happygithub1123/stm32-multimeter-replica/参考手册/器件手册索引.md

# 天空星数字万用表关键器件手册索引

整理日期：2026-09-18

筛选依据：当前项目的 `SCH_Schematic1_2_2026-09-17.pdf` 、`README.md` 和两套 STM32 固件。手册按“主控/显示、模拟测量链、量程切换、供电和输入保护”选取。

## 主控和显示

| 文件 | 对应器件 | 项目中的作用 | 来源 |
| --- | --- | --- | --- |
| [01_STM32F405-407_DS8626.pdf](01_STM32F405-407_DS8626.pdf) | STM32F407VET6 | 天空星主控 MCU，关键查阅 ADC、GPIO、SPI和电气参数 | [STMicroelectronics](https://www.st.com/resource/en/datasheet/stm32f407ig.pdf) |
| [02_STM32F4_RM0090_参考手册.pdf](02_STM32F4_RM0090_%E5%8F%82%E8%80%83%E6%89%8B%E5%86%8C.pdf) | STM32F407 外设 | 寄存器级参考手册，用于 ADC、DMA、SPI、定时器等调试 | [STMicroelectronics](https://www.st.com/resource/en/reference_manual/rm0090-stm32f4xx-reference-manual-stmicroelectronics.pdf) |
| [07_ST7735S_TFT控制器_数据手册.pdf](07_ST7735S_TFT%E6%8E%A7%E5%88%B6%E5%99%A8_%E6%95%B0%E6%8D%AE%E6%89%8B%E5%86%8C.pdf) | ST7735S | 1.8 英寸 128×160 TFT 模块控制器；固件初始化序列明确标注 ST7735S | [Sitronix 文档镜像](https://cdn.sparkfun.com/assets/9/0/2/5/8/ST7735S_v1.1.pdf) |

## 模拟测量链

| 文件 | 对应器件 | 项目中的作用 | 来源 |
| --- | --- | --- | --- |
| [03_TLV333-TLV2333-TLV4333_数据手册.pdf](03_TLV333-TLV2333-TLV4333_%E6%95%B0%E6%8D%AE%E6%89%8B%E5%86%8C.pdf) | TLV2333IDR、TLV333IDBVR | 电压差分放大、VREF 缓冲和电阻测量缓冲；同一份 TI 家族手册覆盖两种型号 | [Texas Instruments](https://www.ti.com/lit/ds/symlink/tlv333.pdf) |
| [04_TP181A1_电流检测放大器_数据手册.pdf](04_TP181A1_%E7%94%B5%E6%B5%81%E6%A3%80%E6%B5%8B%E6%94%BE%E5%A4%A7%E5%99%A8_%E6%95%B0%E6%8D%AE%E6%89%8B%E5%86%8C.pdf) | TP181A1-CR | 10 mΩ 分流器的双向电流检测，A1 型号固定增益 50 V/V | [3PEAK](https://static.3peak.com/res/doc/ds/Datasheet_TP181.pdf) |

## 量程切换和供电

| 文件 | 对应器件 | 项目中的作用 | 来源 |
| --- | --- | --- | --- |
| [05_GAQY211G2S_固态继电器_数据手册.pdf](05_GAQY211G2S_%E5%9B%BA%E6%80%81%E7%BB%A7%E7%94%B5%E5%99%A8_%E6%95%B0%E6%8D%AE%E6%89%8B%E5%86%8C.pdf) | GAQY211G2S | RES/VOL/CUR 通路选择，SOP-4 PhotoMOS 固态继电器 | [国晶微/SUPSiC（立创商城存档）](https://atta.szlcsc.com/upload/public/pdf/source/20251020/01ECD8E450E4AE083754AEA475BAC51E.pdf) |
| [08_AO3401_P沟道MOSFET_数据手册.pdf](08_AO3401_P%E6%B2%9F%E9%81%93MOSFET_%E6%95%B0%E6%8D%AE%E6%89%8B%E5%86%8C.pdf) | AO3401 | 100 Ω/1 kΩ/10 kΩ/100 kΩ 电阻量程切换 | [Alpha & Omega Semiconductor](https://www.aosmd.com/sites/default/files/res/datasheets/AO3401.pdf) |
| [06_LP5907_低噪声LDO_数据手册.pdf](06_LP5907_%E4%BD%8E%E5%99%AA%E5%A3%B0LDO_%E6%95%B0%E6%8D%AE%E6%89%8B%E5%86%8C.pdf) | LP5907MFX-3.3/NOPB | 5 V 转 3.3 V 模拟电源 | [Texas Instruments](https://www.ti.com/lit/ds/symlink/lp5907.pdf) |

## 输入保护和辅助开关

| 文件 | 对应器件 | 项目中的作用 | 来源 |
| --- | --- | --- | --- |
| [09_SJD12C40L01_TVS_数据手册.pdf](09_SJD12C40L01_TVS_%E6%95%B0%E6%8D%AE%E6%89%8B%E5%86%8C.pdf) | SJD12C40L01 | 40 V 双向 TVS，用于表笔/通路节点的瞬态保护 | [YAGEO](https://yageogroup.com/content/datasheet/asset/file/SJD12ACXXXL01_1) |
| [10_BSMD0603-010-36V_自恢复保险丝_数据手册.pdf](10_BSMD0603-010-36V_%E8%87%AA%E6%81%A2%E5%A4%8D%E4%BF%9D%E9%99%A9%E4%B8%9D_%E6%95%B0%E6%8D%AE%E6%89%8B%E5%86%8C.pdf) | BSMD0603-010-36V | 黑表笔负极控制支路的 36 V/0.1 A PPTC 自恢复保护 | [BHFUSE（立创商城存档）](https://atta.szlcsc.com/upload/public/pdf/source/20250403/B24B506D17FD49D2D6A20D6D815FE6C1.pdf) |
| [11_2N7002K_N沟道MOSFET_数据手册.pdf](11_2N7002K_N%E6%B2%9F%E9%81%93MOSFET_%E6%95%B0%E6%8D%AE%E6%89%8B%E5%86%8C.pdf) | 2N7002K | 黑表笔负极控制开关 | [Diodes Incorporated](https://www.diodes.com/datasheet/download/2N7002K.pdf) |

## 型号核对说明

- 原理图中是 **GAQY211G2S**，不是 Panasonic **AQY211G2S**。两者额定电流等参数不同，本目录保留的是 GAQY211G2S 精确型号手册。
- TLV2333IDR 和 TLV333IDBVR 属于 TLVx333 家族，TI 将两者放在同一份数据手册中。
- SJD12C40L01 使用 YAGEO `SJD12A(C)XXXL01` 系列手册，其精确型号列在 40 V 参数行。
- 2N7002K 是多厂商通用型号；原理图未标注厂商，此处收录 Diodes Incorporated 版本作为电气特性参考，采购时仍应按实际厂牌复核。

## 完整性检查

共 11 份 PDF。已检查 PDF 文件头、可解析页数，并核对手册中的关键型号。
