happygithub1123/stm32-multimeter-replica/说明文档.md

# 代码说明

- 简易万用表有两个版本，分别对应两个版本的代码；
- 两个版本代码有细微差异，不和互用；
