happygithub1123/stm32-multimeter-replica/原理图/SCH_Schematic1_2_2026-09-17.pdf

左边H1 | 右边H2

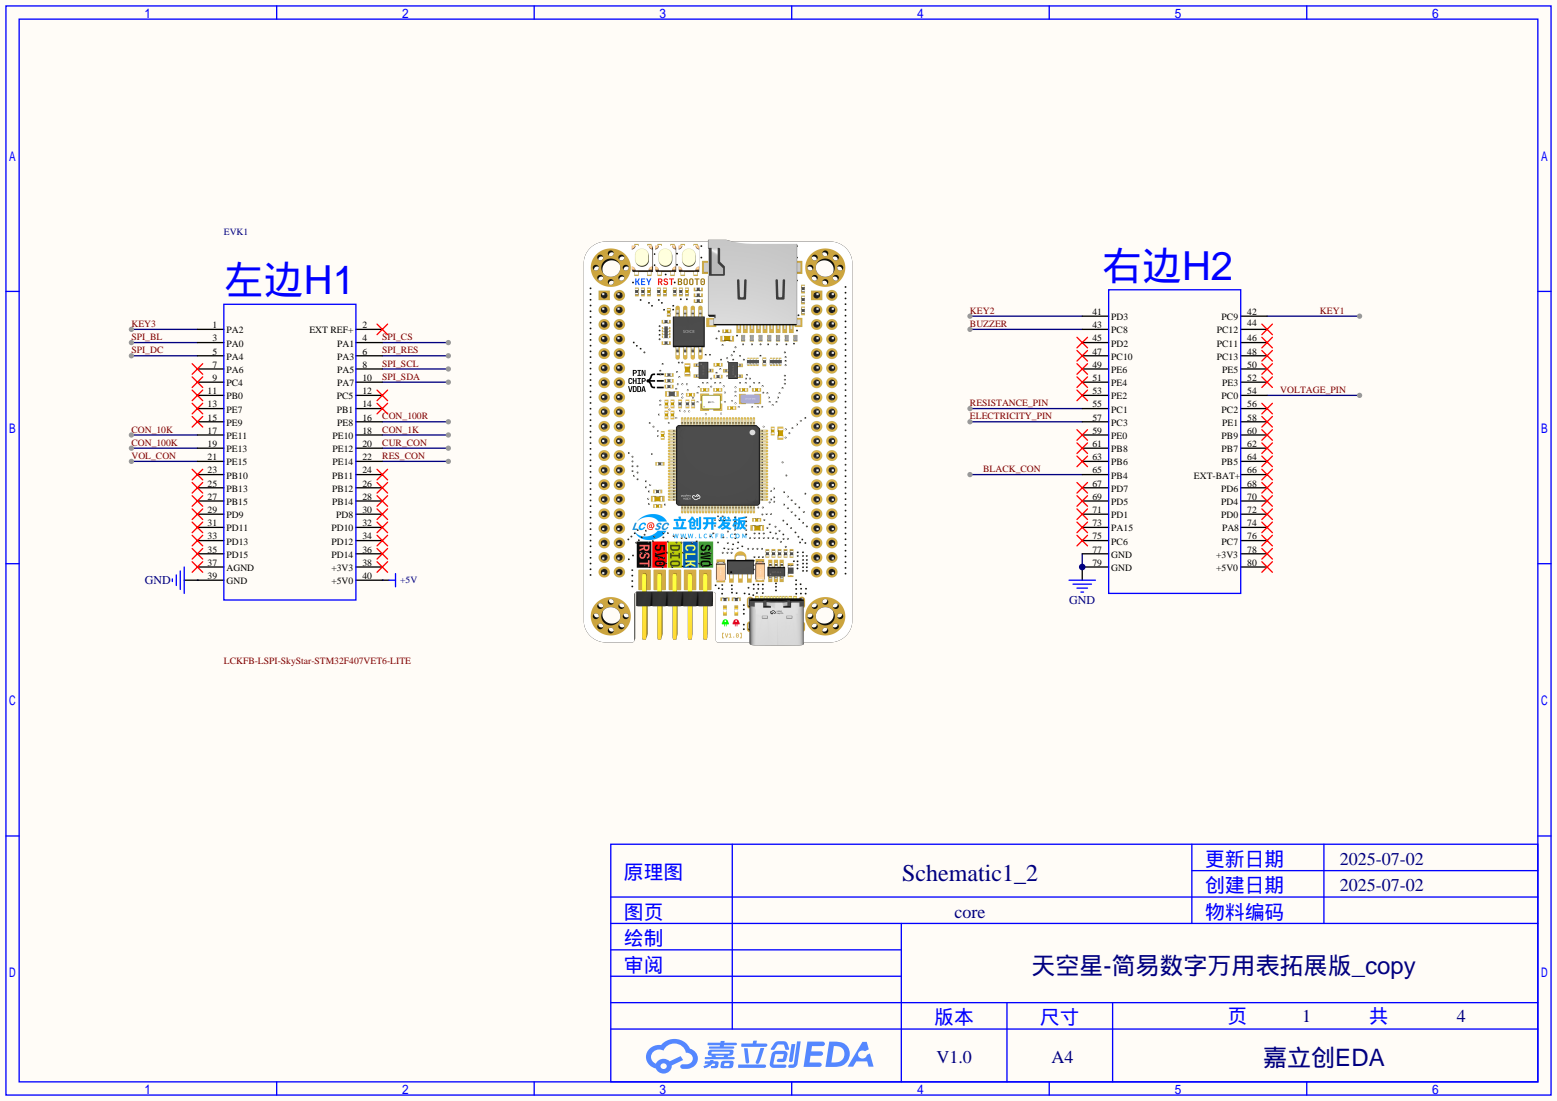
[picture p6: page 1]

LCKFB-LSPI-SkyStar-STM32F407VET6-LITE

U1

## 1.8寸TFT屏模块-8Pin

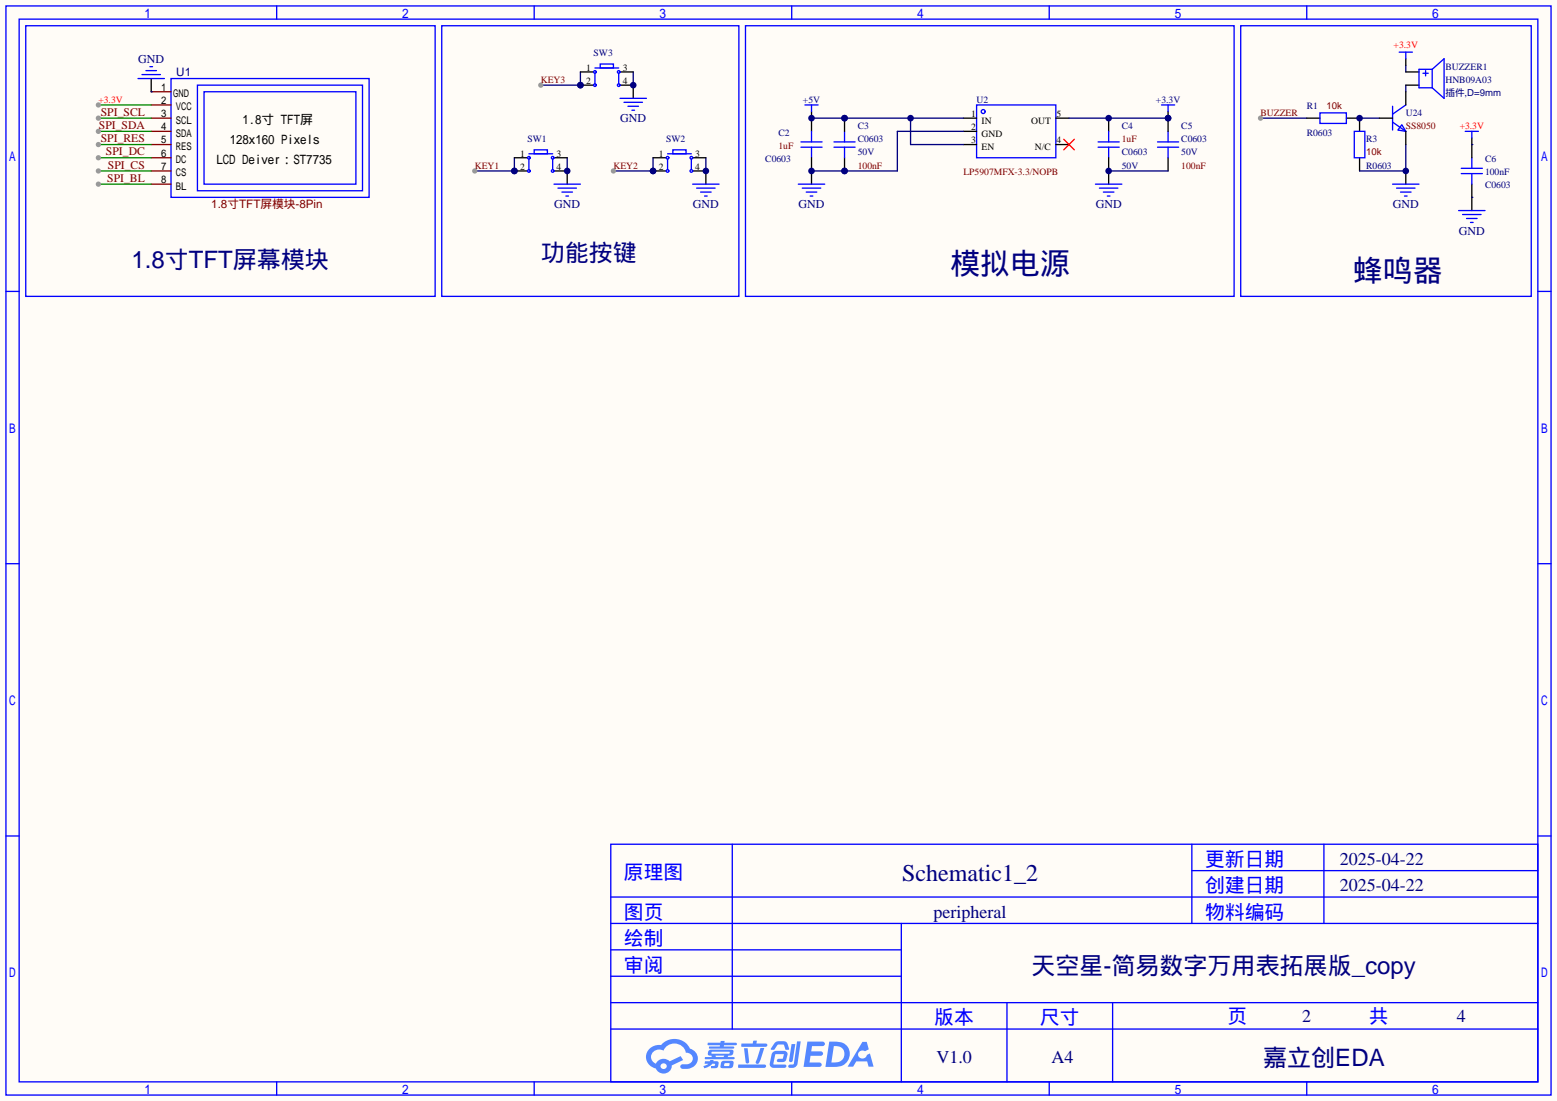
[picture p7: page 2]

### GND

### GND

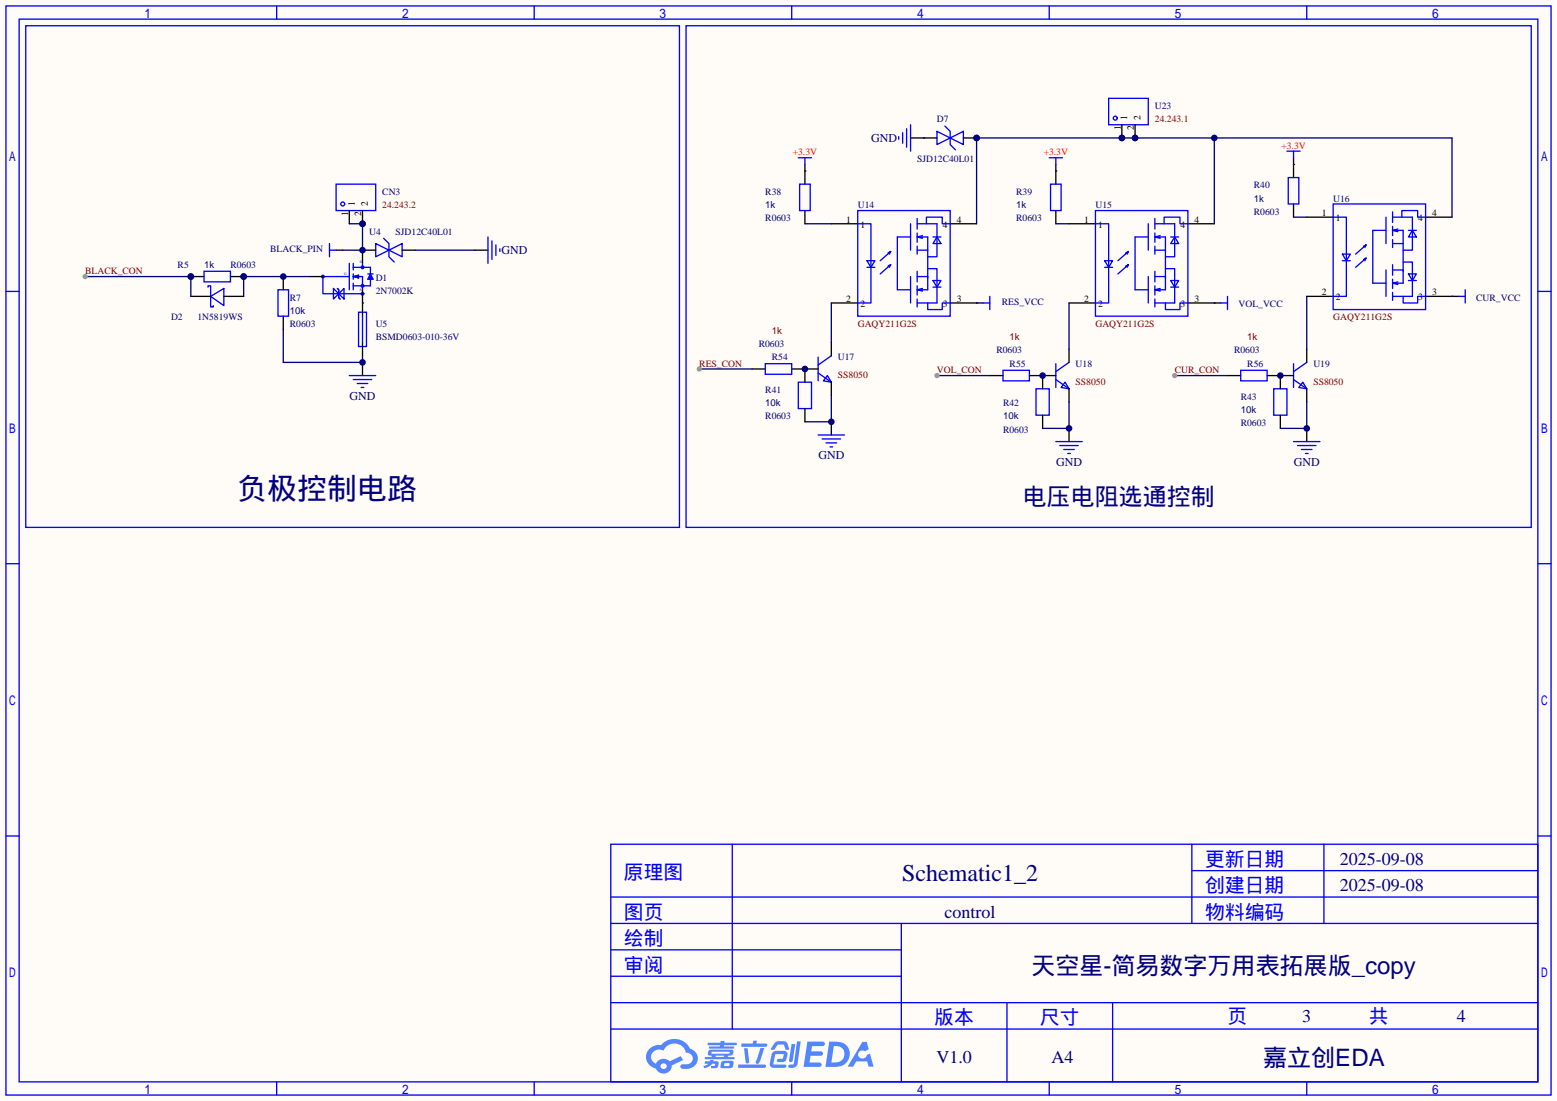
[picture p8: page 3]

### GND

### GND

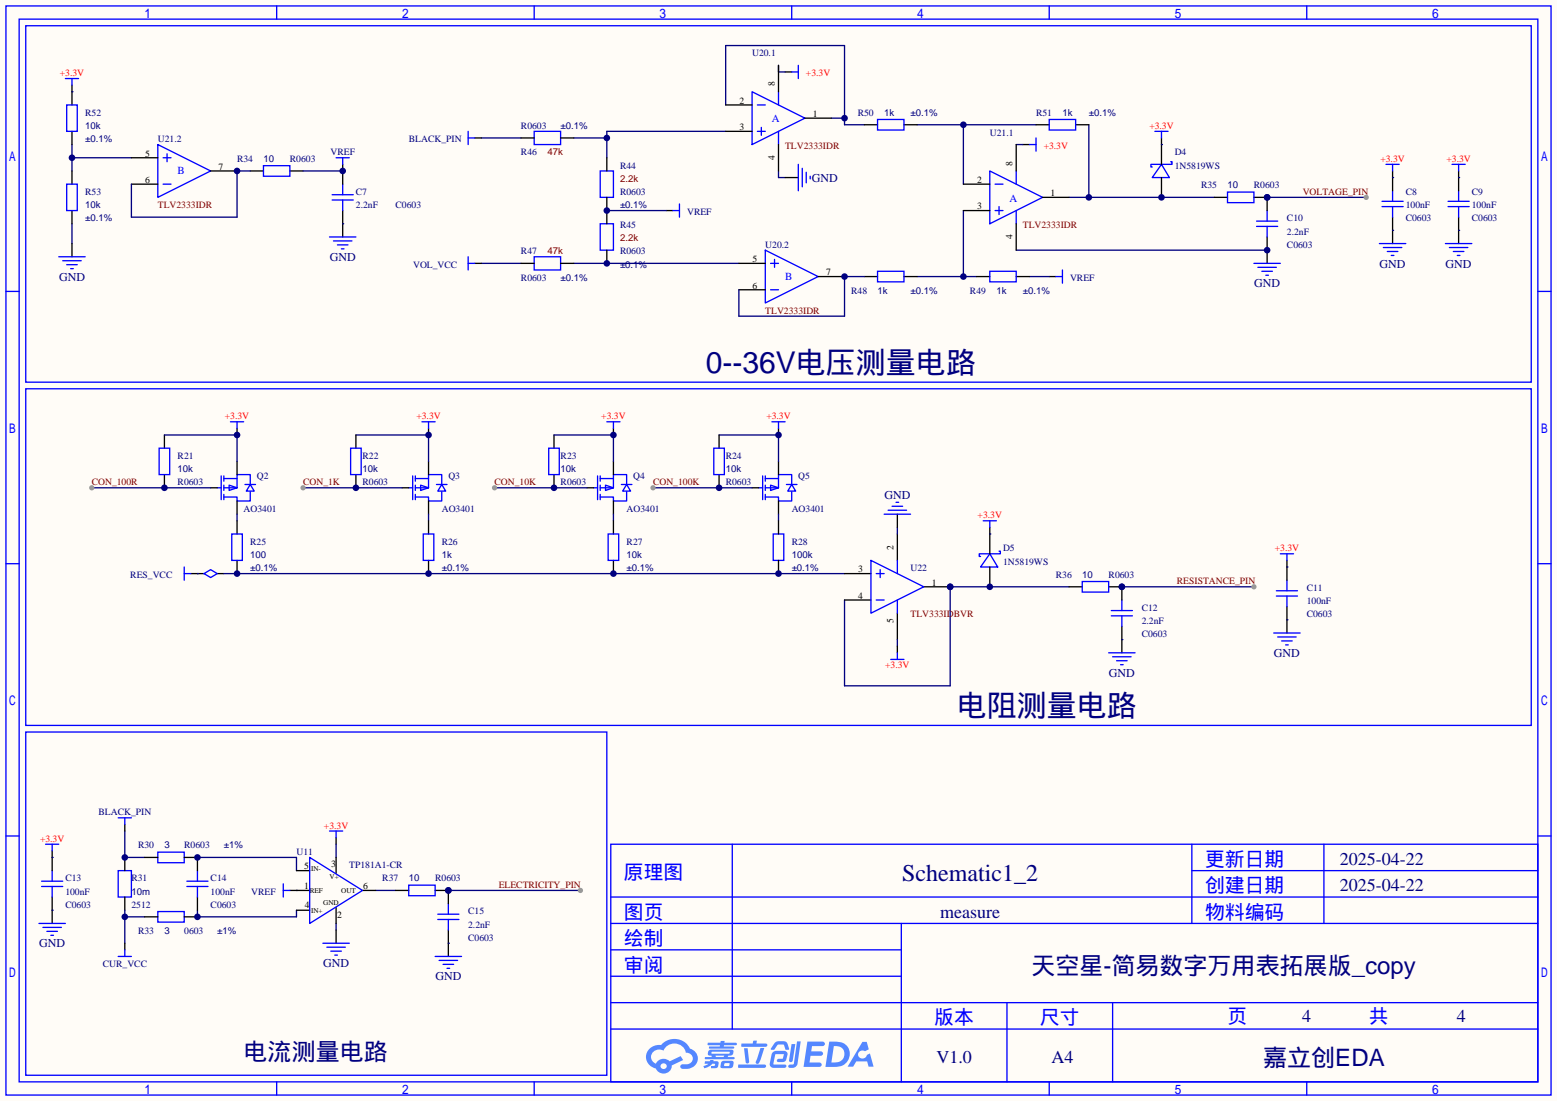
[picture p9: page 4]
