happygithub1123/stm32-multimeter-replica/stm32-multimeter-V2.0/Core/Src/main.c

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
/* Includes ------------------------------------------------------------------*/
#include "main.h"
#include "adc.h"
#include "iwdg.h"
#include "spi.h"
#include "tim.h"
#include "gpio.h"

/* USER CODE BEGIN Includes */
#include "bsp_key.h"
#include "bsp_tft.h"
#include "bsp_tftinit.h"
#include "bsp_timer.h"
#include "bsp_task.h"
/* USER CODE END Includes */


void SystemClock_Config(void);
/**
  * @brief  The application entry point.
  * @retval int
  */
int main(void)
{
  /* USER CODE BEGIN 1 */
	uint8_t keyValue = 0;							//获取按键值
	struct KeyInfo keyinfo = {0};			//按键切换信息
	
	keyinfo.mode = VOL_MODE;					//当前模式
	keyinfo.resistor_range = RES_0_100R;	//默认电阻分压
	keyinfo.ref_vol_value = 0;				//默认参考电压
  /* USER CODE END 1 */

  /* MCU Configuration--------------------------------------------------------*/

  /* Reset of all peripherals, Initializes the Flash interface and the Systick. */
  HAL_Init();

  /* Configure the system clock */
  SystemClock_Config();

  /* Initialize all configured peripherals */
  MX_GPIO_Init();
  MX_ADC1_Init();
  MX_SPI1_Init();
  MX_TIM3_Init();
  MX_IWDG_Init();
  /* USER CODE BEGIN 2 */
	//设置通道为内部参考电压
	Set_ADC_Channel(ADC_CHANNEL_VREFINT);
	keyinfo.ref_vol_value = Get_ADC_Average(200);	//获取200次平均值
	
	TFT_Init();											//初始化屏幕
	TFT_ShowStaticUI(keyinfo);			//显示静态UI
	HAL_TIM_Base_Start_IT(&htim3);	//消息定时器开始计时
	Mode_Switch(keyinfo.mode);			//模式切换所做操作
  /* USER CODE END 2 */

  /* Infinite loop */
  /* USER CODE BEGIN WHILE */
  while (1)
  {
    /* USER CODE END WHILE */

    /* USER CODE BEGIN 3 */
		if(wdgTimer >= 50)
		{
			HAL_IWDG_Refresh(&hiwdg);		//每隔50ms喂一次狗
			wdgTimer = 0;
		}
		if(keyTimer >= 10)						//每10ms进行按键扫描
		{	
			keyTimer = 0;
			keyValue = key_scanf();
			if(keyValue!=KEY_ERROR){
				key_handle(keyValue,&keyinfo);	//如果有按键按下则进行处理
			}	
			keyValue = KEY_ERROR;
		}
		if(keyinfo.mode == VOL_MODE)
		{
			//电压测量任务
			Voltage_Task(keyinfo.ref_vol_value);
		}
		else if(keyinfo.mode == RES_MODE)
		{
			//电阻测量任务
			Resistor_Task(&keyinfo,keyinfo.ref_vol_value);
		}
		else if(keyinfo.mode == CUR_MODE)
		{
			//电流测量任务
			Electricity_Task(keyinfo.ref_vol_value);
		}
		else if(keyinfo.mode == BUZ_MODE)
		{
			//通断测量任务
			Buzzing_Task(keyinfo.ref_vol_value);
		}
		else if(keyinfo.mode == DIODE_MODE)
		{
			//二极管测量任务
			Dio_Task(keyinfo.ref_vol_value);
		}
  }
  /* USER CODE END 3 */
}

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
