happygithub1123/stm32-multimeter-replica/stm32-multimeter-V2.0/Core/Inc/main.h

#define SPI_BL_Pin GPIO_PIN_0
#define SPI_BL_GPIO_Port GPIOA
#define SPI_CS_Pin GPIO_PIN_1
#define SPI_CS_GPIO_Port GPIOA
#define KEY3_Pin GPIO_PIN_2
#define KEY3_GPIO_Port GPIOA
#define SPI_RES_Pin GPIO_PIN_3
#define SPI_RES_GPIO_Port GPIOA
#define SPI_DC_Pin GPIO_PIN_4
#define SPI_DC_GPIO_Port GPIOA
#define CON_100R_Pin GPIO_PIN_8
#define CON_100R_GPIO_Port GPIOE
#define CON_1K_Pin GPIO_PIN_10
#define CON_1K_GPIO_Port GPIOE
#define CON_10K_Pin GPIO_PIN_11
#define CON_10K_GPIO_Port GPIOE
#define CUR_CON_Pin GPIO_PIN_12
#define CUR_CON_GPIO_Port GPIOE
#define CON_100K_Pin GPIO_PIN_13
#define CON_100K_GPIO_Port GPIOE
#define RES_CON_Pin GPIO_PIN_14
#define RES_CON_GPIO_Port GPIOE
#define VOL_CON_Pin GPIO_PIN_15
#define VOL_CON_GPIO_Port GPIOE
#define BUZZER_Pin GPIO_PIN_8
#define BUZZER_GPIO_Port GPIOC
#define KEY1_Pin GPIO_PIN_9
#define KEY1_GPIO_Port GPIOC
#define KEY2_Pin GPIO_PIN_3
#define KEY2_GPIO_Port GPIOD
#define BLACK_CON_Pin GPIO_PIN_4
#define BLACK_CON_GPIO_Port GPIOB
#define Res_Ohm			0x01
#define Res_KiloOhm	0x02
#define Res_TeraOhm	0x03
#define MAX_SAMPNUM 100	
