happygithub1123/stm32-multimeter-replica/stm32-multimeter-V2.0/BSP_Library/bsp_tftinit.c

#include "bsp_tftinit.h"
#include "spi.h"

/*
*   函数内容：TFT发送单个字节数据
*   函数参数：无
*   返回值：无
*/
void TFT_WR_DATA8(uint8_t data)
{
	LCD_CS_Clr();   //拉低片选信号
    
	HAL_SPI_Transmit(&hspi1,&data,1,HAL_MAX_DELAY);
    
	LCD_CS_Set();     //拉高片选信号
}

/*
*   函数内容：TFT发送2个字节数据
*   函数参数：无
*   返回值：无
*/
void TFT_WR_DATA(uint16_t data)
{
	uint8_t sendData[2] = {0};
	sendData[0] = (data>>8);
	sendData[1] = (data);
    
	LCD_CS_Clr();   //拉低片选信号
   
	HAL_SPI_Transmit(&hspi1,sendData,2,HAL_MAX_DELAY);     
    
	LCD_CS_Set();     //拉高片选信号
}

/*
*   函数内容：TFT发送命令数据
*   函数参数：无
*   返回值：无
*/
void TFT_WR_REG(uint8_t reg)
{
	LCD_DC_Clr();   //拉低命令信号
	LCD_CS_Clr();   //拉低片选信号

	HAL_SPI_Transmit(&hspi1,&reg,1,HAL_MAX_DELAY);   

	LCD_CS_Set();     //拉高片选信号
	LCD_DC_Set();     //拉高命令信号
}

void TFT_Address_Set(uint16_t x1,uint16_t y1,uint16_t x2,uint16_t y2)
{
	TFT_WR_REG(0x2a);//列地址设置
	TFT_WR_DATA(x1);
	TFT_WR_DATA(x2);
	TFT_WR_REG(0x2b);//行地址设置
	TFT_WR_DATA(y1);
	TFT_WR_DATA(y2);
	TFT_WR_REG(0x2c);//储存器写
}

void TFT_Init(void)
{
	LCD_RES_Clr();  	//复位
	HAL_Delay(100);
	LCD_RES_Set();     //复位完成
	HAL_Delay(100);
	
	LCD_BLK_Set();     //打开背光
	HAL_Delay(100);
    
	//************* Start Initial Sequence **********//
	TFT_WR_REG(0x11); //Sleep out 
	HAL_Delay(120);              //Delay 120ms 
	//------------------------------------ST7735S Frame Rate-----------------------------------------// 
	TFT_WR_REG(0xB1); 
	TFT_WR_DATA8(0x05); 
	TFT_WR_DATA8(0x3C); 
	TFT_WR_DATA8(0x3C); 
	TFT_WR_REG(0xB2); 
	TFT_WR_DATA8(0x05);
	TFT_WR_DATA8(0x3C); 
	TFT_WR_DATA8(0x3C); 
	TFT_WR_REG(0xB3); 
	TFT_WR_DATA8(0x05); 
	TFT_WR_DATA8(0x3C); 
	TFT_WR_DATA8(0x3C); 
	TFT_WR_DATA8(0x05); 
	TFT_WR_DATA8(0x3C); 
	TFT_WR_DATA8(0x3C); 
	//------------------------------------End ST7735S Frame Rate---------------------------------// 
	TFT_WR_REG(0xB4); //Dot inversion 
	TFT_WR_DATA8(0x03); 
	//------------------------------------ST7735S Power Sequence---------------------------------// 
	TFT_WR_REG(0xC0); 
	TFT_WR_DATA8(0x28); 
	TFT_WR_DATA8(0x08); 
	TFT_WR_DATA8(0x04); 
	TFT_WR_REG(0xC1); 
	TFT_WR_DATA8(0XC0); 
	TFT_WR_REG(0xC2); 
	TFT_WR_DATA8(0x0D); 
	TFT_WR_DATA8(0x00); 
	TFT_WR_REG(0xC3); 
	TFT_WR_DATA8(0x8D); 
	TFT_WR_DATA8(0x2A); 
	TFT_WR_REG(0xC4); 
	TFT_WR_DATA8(0x8D); 
	TFT_WR_DATA8(0xEE); 
	//---------------------------------End ST7735S Power Sequence-------------------------------------// 
	TFT_WR_REG(0xC5); //VCOM 
	TFT_WR_DATA8(0x1A); 
	TFT_WR_REG(0x36); //MX, MY, RGB mode 
	if(USE_HORIZONTAL==0){
        TFT_WR_DATA8(0x00);
    }
	else if(USE_HORIZONTAL==1){
        TFT_WR_DATA8(0xC0);
    }
	else if(USE_HORIZONTAL==2){
        TFT_WR_DATA8(0x70);
    }
	else {
        TFT_WR_DATA8(0xA0); 
    }
	//------------------------------------ST7735S Gamma Sequence---------------------------------// 
	TFT_WR_REG(0xE0); 
	TFT_WR_DATA8(0x04); 
	TFT_WR_DATA8(0x22); 
	TFT_WR_DATA8(0x07); 
	TFT_WR_DATA8(0x0A); 
	TFT_WR_DATA8(0x2E); 
	TFT_WR_DATA8(0x30); 
	TFT_WR_DATA8(0x25); 
	TFT_WR_DATA8(0x2A); 
	TFT_WR_DATA8(0x28); 
	TFT_WR_DATA8(0x26); 
	TFT_WR_DATA8(0x2E); 
	TFT_WR_DATA8(0x3A); 
	TFT_WR_DATA8(0x00); 
	TFT_WR_DATA8(0x01); 
	TFT_WR_DATA8(0x03); 
	TFT_WR_DATA8(0x13); 
	TFT_WR_REG(0xE1); 
	TFT_WR_DATA8(0x04); 
	TFT_WR_DATA8(0x16); 
	TFT_WR_DATA8(0x06); 
	TFT_WR_DATA8(0x0D); 
	TFT_WR_DATA8(0x2D); 
	TFT_WR_DATA8(0x26); 
	TFT_WR_DATA8(0x23); 
	TFT_WR_DATA8(0x27); 
	TFT_WR_DATA8(0x27); 
	TFT_WR_DATA8(0x25); 
	TFT_WR_DATA8(0x2D); 
	TFT_WR_DATA8(0x3B); 
	TFT_WR_DATA8(0x00); 
	TFT_WR_DATA8(0x01); 
	TFT_WR_DATA8(0x04); 
	TFT_WR_DATA8(0x13); 
	//------------------------------------End ST7735S Gamma Sequence-----------------------------// 
	TFT_WR_REG(0x3A); //65k mode 
	TFT_WR_DATA8(0x05); 
	TFT_WR_REG(0x29); //Display on   
}
