happygithub1123/stm32-multimeter-replica/stm32-multimeter-V2.0/Core/Inc/gpio.h

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
/* Define to prevent recursive inclusion -------------------------------------*/
#ifndef __GPIO_H__
#define __GPIO_H__

#ifdef __cplusplus
extern "C" {
#endif

/* Includes ------------------------------------------------------------------*/
#include "main.h"

void MX_GPIO_Init(void);

/* USER CODE BEGIN Prototypes */
void Relay_Connect_RES(void);
void Relay_Connect_VOL(void);
void Relay_Connect_CUR(void);
void Connect_GND(void);
void DisCon_GND(void);
void Resostor_Connect_100R(void);
void Resostor_Connect_1K(void);
void Resostor_Connect_10K(void);
void Resostor_Connect_100K(void);
void Open_Beep(void);
void Closer_Beep(void);
/* USER CODE END Prototypes */

#ifdef __cplusplus
}
#endif
#endif /*__ GPIO_H__ */
