happygithub1123/stm32-multimeter-replica/(commit log)

2026-09-17 首次公开上传：整理天空星数字万用表复刻代码及中文说明
    收录原版与V2.0固件工程、HAL/CMSIS依赖和原附带HEX；新增中文README、来源截图、复刻声明及原项目V1.2改动说明；保留原始许可，排除编译中间文件。
2026-09-17 补充V1.2小表笔原理图并明确本次复刻版本
2026-09-17 将原理图PDF标记为二进制文件，保留原始内容
2026-09-17 补充立创Wiki项目介绍与电路原理链接
2026-09-18 文档：添加关键器件数据手册
2026-09-18 修复电流挡位零点显示溢出
2026-09-18 添加 VS Code 与 EIDE 工程配置
