happygithub1123/stm32-multimeter-replica/(notices)

Notices in the files:
stm32-multimeter-V2.0/Core/Inc/gpio.h:
Copyright (c) 2025 STMicroelectronics.
All rights reserved.
This software is licensed under terms that can be found in the LICENSE file
